BrewTroller/BoardFiles/Phoenix 2.0/Bill-of-Materials-BrewTroller-Phoenix-exported-2017-03-02.xls

BrewTroller Phoenix
# | Designator | Footprint | Package ID | Company P/N | Identifier | Description | ROHS | Quantity | Manufacturer | Manufacturer P/N | Supplier | Supplier P/N | Notes | Price | Total Cost | Datasheet
1 | C1 C2 C3 C4 C6 C7 C12 C13 C14 C15 C16 C17 C18 C20 C21 C22 C23 C25 C26 C27 C28 C30 C31 C32 C33 C34 C35 C36 C38 C40 C46 C47 C48 C49 C50 C51 C52 C53 C54 C55 C56 C57 |  |  | CAP-SMD-3 |  | 0603 0.1 uF 50 V -20 / +80 % Tolerance Y5V SMT Multilayer Ceramic Capacitor |  | 42 | Yageo | CC0603ZRY5V9BB104 | Digikey | 311-1343-1-ND |  | 0.0366 | 1.5372 | http://datasheet.octopart.com/CC0603ZRY5V9BB104-Yageo-datasheet-10882999.pdf
2 | C24 C29 C37 C45 |  |  | CAP-SMD-4 |  | 0603 18 pF 50 V ±5% Tolerance C0G SMT Multilayer Ceramic Capacitor |  | 4 | Murata | GRM1885C1H180JA01D | Digikey | 490-1409-1-ND |  | 0.0222 | 0.0888 | http://datasheet.octopart.com/GRM1885C1H180JA01D-Murata-datasheet-8817987.pdf
3 | C41 C42 C43 C44 |  |  | CAP-SMD-7 |  | Cap Ceramic 0.3pF 50V C0G 0.1pF SMD 0603 125°C Paper T/R |  | 4 | Samsung | CL10C0R3BB8NNNC | Digikey | CL10C0R3BB8NNNC |  | 0.004 | 0.016 | http://datasheet.octopart.com/CL10C0R3BB8NNNC-Samsung-Electro-Mechanics-datasheet-11801255.pdf
4 | C8 |  |  | CAP-SMD-8 |  | 0603 160 pF 50 V ±5% Tolerance C0G SMT Multilayer Ceramic Capacitor |  | 1 | Murata | GRM1885C1H161JA01D | Ali Express | GRM1885C1H161JA01D |  | 0.0254 | 0.0254 | http://datasheet.octopart.com/GRM1885C1H161JA01D-Murata-datasheet-12553306.pdf
5 | C19 |  |  | CAP-SMD-9 |  | 0603 1UF 105K X5R 50V +-10% SMD Ceramic capacitor CL31A106KOHNNNE 4000PCS RoHS 100% rohs novo! SAMSUNG |  | 1 | Samsung | CL31A106KOHNNNE | Aliexpress | CL31A106KOHNNNE |  | 0.01 | 0.01
6 | C39 |  |  | CAP-SMD-ALUM-1 |  | UD Series 68 uF 35 V 105°C Ø6.3 x 7.7mm SMT Chip Aluminum Electrolytic Cap |  | 1 | Nichicon | UUD1V680MCL1GS | Ali Express | UUD1V680MCL1GS |  | 0.1182 | 0.1182 | http://datasheet.octopart.com/UUD1V680MCL1GS-Nichicon-datasheet-12981252.pdf
7 | C5 |  |  | CAP-SMD-ALUM-2 |  | WX Series 100 uF 25 V ±20 % Surface Mount Chip Aluminum Electrolytic Capacitor |  | 1 | Nichicon | UWX1E101MCL1GB |  | 493-2113-1-ND |  | 0.2106 | 0.2106 | http://datasheet.octopart.com/UWX1E101MCL1GB-Nichicon-datasheet-12519344.pdf
8 | C10 C9 |  |  | CAP-SMD-Polymer-2 |  | HS Series 1000 uF 6.3V 20% Surface Mount Polymer Aluminum Electrolytic Capacitor |  | 2 | Nichicon | RHS0J102MCN1GS |  | 493-3774-2-ND |  | 0.9064 | 1.8128 | http://datasheet.octopart.com/RHS0J102MCN1GS-Nichicon-datasheet-12513564.pdf
9 | C11 |  |  | CAP-TANT-SMD-3 |  | Cap Tant Solid 22uF 6.3V B CASE 20% (3.5 X 2.8 X 1.9mm) SMD 3528-21 2.5 Ohm 125C Automotive T/R |  | 1 | Kemet | T491B226M006AT |  | 399-8313-1-ND |  | 0.2102 | 0.2102 | http://datasheet.octopart.com/T491B226M006AT-Kemet-datasheet-41473941.pdf
10 | XTAL1 |  |  | CRYSTAL-SMD-1 |  | Crystal 16MHz ??30ppm (Tol) ??30ppm (Stability) 18pF FUND 40Ohm 4-Pin SMD T/R |  | 1 | TXC | 7B-16.000MAAJ-T | Digikey | 7B-16.000MAAJ-T |  | 0.726 | 0.726 | http://datasheet.octopart.com/7B-16.000MAAJ-T-TXC-datasheet-8857370.pdf
11 | XTAL2 |  |  | CRYSTAL-SMD-2 |  | Crystal 25.0000mhz 18pf Smd |  | 1 | TXC | 7B-25.000MAAJ-T | Digikey | 7B-25.000MAAJ-T |  | 0.726 | 0.726 | http://datasheet.octopart.com/7B-25.000MAAJ-T-TXC-datasheet-10214950.pdf
12 | D1 |  |  | DIODE-SMD-2 |  | DIODE, TVS, 12V, 400W; Diode Type: TVS, Unidirectional; Voltage, Vbr: 14.7V; Power, Peak Pulse: 400W; Case Style: SMA... |  | 1 | Multicomp | SMAJ12A | Ali Express | SMAJ12A |  | 0.2214 | 0.2214 | http://datasheet.octopart.com/SMAJ12A-Multicomp-datasheet-10125818.pdf
13 | D2 |  |  | DIODE-SMD-SCH-1 |  | B250A Series 50 V 2 A Surface Mount Schottky Barrier Rectifier - DO-214AC |  | 1 | Diodes Inc. | B250A-13-F | Digikey | B250A-13-F |  | 0.391 | 0.391 | http://datasheet.octopart.com/B250A-13-F-Diodes-Inc.-datasheet-46751036.pdf
14 | D10 D3 D4 D5 D6 D7 D8 D9 |  |  | DIODE-ZENER-1 |  | BZX384 Series 5.1 V ±5 % 300 mW Surface Mount Voltage Regulator Diode - SOD323 |  | 8 | NXP Semiconductors | BZX384-C5V1,115 |  | 568-8045-2-ND |  | 0.1621 | 1.2968 | http://datasheet.octopart.com/BZX384-C5V1%2C115-NXP-Semiconductors-datasheet-8360268.pdf
15 | L1 L3 L5 L6 L7 L8 |  |  | FERRITE-SMD-2 |  | Ferrite Beads High Current Chip 100Ohm 25% 100MHz 3A 35mOhm DCR 1206 T/R |  | 6 | Laird | HI1206N101R-10 | Digikey | HI1206N101R-10 |  | 0.055 | 0.33 | http://datasheet.octopart.com/HI1206N101R-10-Steward-datasheet-14357201.pdf
16 | L4 |  |  | FERRITE-SMD-3 |  | Ind Chip Bead Multi-Layer 100Ohm 25% 100MHz Ferrite 3A 0603 Punched Paper T/R |  | 1 | TDK | MPZ1608S101ATAH0 |  | 445-1564-1-ND |  | 5.0036 | 5.0036 | http://datasheet.octopart.com/MPZ1608S101ATAH0-TDK-datasheet-8852356.pdf
17 | L2 |  |  | FIX-IND-SMD-1 |  | Inductor Power Shielded Wirewound 3.5uH/5.4uH 30% 100KHz 2.5A 33mOhm DCR T/R |  | 1 | Pulse | P1167.542NLT | Digikey | P1167.542NLT |  | 1.613 | 1.613 | http://datasheet.octopart.com/P1167.542NLT-Pulse-datasheet-5389958.pdf
18 | U$6 |  |  | FUSE-SMD-1 |  | 2018 SMD PTC Resettable Fuses, 15V, 1.5A |  | 1 | Bourns | MF-SMDF150-2 | Digikey | MF-SMDF150-2TR-ND |  | 0.5004 | 0.5004 | http://datasheet.octopart.com/MF-SMDF150-2-Bourns-datasheet-8547340.pdf
19 | X3 |  |  | HEADER-TH-M-1 |  | Wire-To-Board Connector, SL 70545 Series, Through Hole, Header, 4, 2.54 mm, Gold Plated Contacts |  | 1 | Molex | 70545-0038 | Digikey | 70545-0038 |  | 0.908 | 0.908 | http://datasheet.octopart.com/70545-0038-Molex-datasheet-13786230.pdf
20 | X2 |  |  | HEADER-TH-M-2 |  | CGrid SL Srd VHdr SR 120 TPg 15Au 5Ckt |  | 1 | Molex | 70545-0039 | Digikey | 70545-0039 |  | 0.8988 | 0.8988 | http://datasheet.octopart.com/70545-0039-Molex-datasheet-37172048.pdf
21 | JP1 JP3 |  |  | HEADER-TH-M-3 |  | Header; PinStrip; CopperAlloy; GlassFilledPolyester; 36Cnts; 2.5A; Straight; 929Series |  | 2 | 3M | 929400-01-36-RK | DIGIKEY | 929400E-01-36-ND |  | 1.22 | 2.44 | http://datasheet.octopart.com/929400-01-36-RK-3M-datasheet-5333537.pdf
22 | IC10 |  |  | IC-SMD-10 |  | 23K256 Series 2.7 to 3.6 V 256 kbit SPI Bus Lower Power Serial SRAM TSSOP-8 |  | 1 | Microchip | 23K256-I/ST | Digikey | 23K256-I/ST |  | 1.1 | 1.1 | http://datasheet.octopart.com/23K256-I/ST-Microchip-datasheet-10414480.pdf
23 | IC12 |  |  | IC-SMD-11 |  | SP485E Series 10 Mbps 5 V Enhanced Low EMI Half Duplex RS-485 Transceiver-NSOIC8 |  | 1 | Exar | SP485ECN-L | Ali Express | SP485ECN-L |  | 0.324 | 0.324 | http://datasheet.octopart.com/SP485ECN-L-Exar-datasheet-17722984.pdf
24 | IC2 |  |  | IC-SMD-12 |  | USB Full Speed to Serial UART IC, Includes Oscillator and EEPROM - SSOP-28 |  | 1 | FTDI | FT232RL-REEL | Ali Express | FT232RL-REEL |  | 1.5152 | 1.5152 | http://datasheet.octopart.com/FT232RL-REEL-FTDI-datasheet-11992319.pdf
25 | IC6 |  |  | IC-SMD-13 |  | Temperature sensor; serial output; -40÷125°C; SOT23A-5; SMD |  | 1 | Microchip | TC74A0-5.0VCTTR | Digikey | TC74A0-5.0VCTTR |  | 0.87 | 0.87 | http://datasheet.octopart.com/TC74A0-5.0VCTTR-Microchip-datasheet-4412.pdf
26 | IC3 IC4 |  |  | IC-SMD-2 |  | 74HC Series 6 V 3-State 8-Bit Serial-In Serial or Parallel-Out Shift Register |  | 2 | NXP Semiconductors | 74HC595D,118 | Digikey | 568-1483-1-ND |  | 0.1552 | 0.3104 | http://datasheet.octopart.com/74HC595D%2C118-Philips-datasheet-11979826.pdf
27 | IC1 |  |  | IC-SMD-3 |  | Conv DC-DC Single Inv/Step Up/Step Down 3V to 40V 8-Pin SOIC T/R |  | 1 | Texas Instruments | MC34063ADR | Digikey | 296-17765-2-ND |  | 0.4638 | 0.4638 | https://octopart-clicks.com/click/track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
28 | IC9 |  |  | IC-SMD-4 |  | LF Series 3.3 V 500 mA Very Low Drop Voltage Regulator With Inhibit - TO-252 |  | 1 | STMicroelectronics | LF33CDT-TR | Digikey | 497-1532-6-ND |  | 0.5422 | 0.5422 | http://datasheet.octopart.com/LF33CDT-TR-STMicroelectronics-datasheet-10887915.pdf
29 | IC5 |  |  | IC-SMD-5 |  | 25AA02E48 Series 2 Kbit (256 x 8) 5.5 V SMT SPI Bus Serial EEPROM - SOT-23-6 |  | 1 | Microchip | 25AA02E48T-I/OT | Digikey | 25AA02E48T-I/OT |  | 0.38 | 0.38 | http://datasheet.octopart.com/25AA02E48T-I/OT-Microchip-datasheet-11068214.pdf
30 | IC7 |  |  | IC-SMD-6 |  | SST26VF032 Series 32 Mb (4M x 8) 3.6 V Serial Quad I/O Flash Memory - SOIJ-8 |  | 1 | Microchip | SST26VF032B-104I/SM | Digikey | SST26VF032B-104I/SM |  | 1.89 | 1.89 | http://datasheet.octopart.com/SST26VF032B-104I-SM-Microchip-datasheet-38329582.pdf
31 | IC13 |  |  | IC-SMD-7 |  | I2C to 1 Wire Bridge Device 8-Pin SOIC N T/R |  | 1 | Maxim Integrated | DS2482S-100+T&R | Digikey | DS2482S-100+T&R |  | 1.58 | 1.58 | http://datasheet.octopart.com/DS2482S-100%2BT%26R-Dallas-Semiconductor-datasheet-12994239.pdf
32 | IC8 |  |  | IC-SMD-8 |  | Wafer with customer specific RDL - 20MHZ, TQFP, IND TEMP, GREEN, 1.8V, T&R/ TQFP (A) |  | 1 | Atmel | ATMEGA1284P-AUR | Ali Express | ATMEGA1284P-AUR |  | 6.28 | 6.28 | http://datasheet.octopart.com/ATMEGA1284P-AUR-Atmel-datasheet-17360070.pdf
33 | IC11 |  |  | IC-SMD-9 |  | MCU 8-bit PIC18 PIC RISC 128KB Flash 1.8V/2.5V/3.3V 64-Pin TQFP Tray |  | 1 | Microchip | PIC18F67J60-I/PT | Ali Express | PIC18F67J60-I/PT |  | 2.2606 | 2.2606 | http://datasheet.octopart.com/PIC18F67J60-I/PT-Microchip-datasheet-11052749.pdf
34 | LED10 LED11 LED12 LED13 LED14 LED15 LED16 LED17 LED18 LED19 LED2 LED20 LED21 LED22 LED23 LED27 LED28 LED29 LED3 LED30 LED4 LED5 LED6 LED7 LED8 LED9 |  |  | LED-SMD-GREEN-1 |  | Green 1.6 x 0.8 x 0.8 mm 130° Water Clear 6 mcd 2.1 V SMT LED |  | 26 | Lite-On | LTST-C190GKT | Ali Express | LTST-C190GKT |  | 0.0115 | 0.299 | http://datasheet.octopart.com/LTST-C190GKT-Lite-On-datasheet-158530.pdf
35 | LED1 |  |  | LED-SMD-RED-1 |  | LED; SMD; 0603; red; 18-54mcd; 1.6x0.8x0.55mm; 130°; 2÷2.4V; 20mA |  | 1 | Lite-On | LTST-C191KRKT | Ali Express | LTST-C191KRKT |  | 0.0121 | 0.0121 | http://datasheet.octopart.com/LTST-C191KRKT-Lite-On-datasheet-158249.pdf
36 | LED24 LED25 LED26 |  |  | LED-TH-TAPERED-GREEN-1 |  |  |  | 3 |  |  |  |  | On Hand | 0 | 0
37 | OK1 |  |  | OPTO-SMD-1 |  | PC817 Series 1 Channel 80 V 5000 Vrms SMT General Purpose Photocoupler - DIP-4 |  | 1 | Sharp Microelectronics | PC817XNNIP0F | Digikey | PC817XNNIP0F |  | 0.384 | 0.384 | http://datasheet.octopart.com/PC817XNNIP0F-Sharp-Microelectronics-datasheet-26446366.pdf
38 | R15 R16 R17 R18 |  |  | RES-ARRAY-SMD-1 |  | Res Thick Film Array 10K Ohm 5% ?200ppm/C ISOL Molded 8-Pin 1206(4 X 0603) Convex SMD T/R |  | 4 | Vishay | CRA06S08310K0JTA | Digikey | CRA6S810KTR-ND |  | 0.0462 | 0.1848 | http://datasheet.octopart.com/CRA06S08310K0JTA-Vishay-datasheet-5334942.pdf
39 | R10 R11 R7 R8 R9 |  |  | RES-ARRAY-SMD-2 |  | Res Thick Film Array 330 Ohm 5% ?200ppm/C ISOL Molded 8-Pin 1206(4 X 0603) Convex SMD Automotive T/R |  | 5 | Panasonic | EXB-38V331JV | Digikey | Y9331TR-ND |  | 0.0312 | 0.156 | http://datasheet.octopart.com/EXB-38V331JV-Panasonic-datasheet-13266625.pdf
40 | R48 R49 |  |  | RES-ARRAY-SMD-3 |  | Res Thick Film Array 3.3K Ohm 5% ?200ppm/C ISOL Molded 8-Pin 1206(4 X 0603) Convex SMD Automotive T/R |  | 2 | Panasonic | EXB-38V332JV | Digikey | EXB-38V332JV |  | 0.0341 | 0.0682 | http://datasheet.octopart.com/EXB-38V332JV-Panasonic-datasheet-13266625.pdf
41 | R14 |  |  | RES-SMD-1 |  | Res Thick Film 2512 0.1 Ohm 5% 1W ±200ppm/°C Molded SMD Embossed Plastic T/R |  | 1 | TE Connectivity / AMP | 1622825-9 | Digikey | A103652DKR-ND |  | 0.243 | 0.243 | http://datasheet.octopart.com/1622825-9-TE-Connectivity---AMP-datasheet-11120217.pdf
42 | R32 |  |  | RES-SMD-12 |  | Res Thick Film 0603 2.26K Ohm 1% 0.1W(1/10W) Â±100ppm/Â°C Molded SMD Automotive Punched T/R |  | 1 | Panasonic | ERJ-3EKF2261V | Digkey | P2.26KHTR-ND |  | 0.0086 | 0.0086 | http://datasheet.octopart.com/ERJ-3EKF2261V-Panasonic-datasheet-13266541.pdf
43 | R38 R44 |  |  | RES-SMD-16 |  | Resistor Thick Film 0603 2k Ohm 5% 1/10 Watt ±200ppm °C Surface Mount Punched Carrier Tape and Reel |  | 2 | Panasonic | ERJ-3GEYJ202V | Digikey | P2.0KGTR-ND |  | 0.0074 | 0.0148 | http://datasheet.octopart.com/ERJ-3GEYJ202V-Panasonic-datasheet-13266872.pdf
44 | R3 |  |  | RES-SMD-18 |  | Res Thick Film 0805 3.3K Ohm 5% 0.125W(1/8W) ?100ppm/C Molded SMD Automotive Paper T/R |  | 1 | Yageo | RC0805JR-073K3L | Digikey | 311-3.3KARCT-ND |  | 0.0306 | 0.0306 | http://datasheet.octopart.com/RC0805JR-073K3L-Yageo-datasheet-8330313.pdf
45 | R5 R6 R19 R25 R51 R53 |  |  | RES-SMD-20 |  | Res Thick Film 0603 330 Ohm 5% 0.1W(1/10W) Â±200ppm/Â°C Molded SMD Automotive Punched T/R |  | 6 | Panasonic | ERJ-3GEYJ331V | Digikey | P330GTR-ND |  | 0.0081 | 0.0486 | http://datasheet.octopart.com/ERJ-3GEYJ331V-Panasonic-datasheet-13266872.pdf
46 | R2 R35 R55 R56 R57 R58 R59 R60 R61 R62 R63 R64 R65 R66 R67 R68 R69 R70 R71 R72 R73 R74 |  |  | RES-SMD-22 |  | Res Thick Film 0603 4.7K Ohm 5% 0.1W(1/10W) Â±200ppm/Â°C Molded SMD Automotive Punched T/R |  | 2 | Panasonic | ERJ-3GEYJ472V | Digikey | P4.7KGTR-ND |  | 0.0081 | 0.0162 | http://datasheet.octopart.com/ERJ-3GEYJ472V-Panasonic-datasheet-13266872.pdf
47 | R29 R31 R43 R45 R52 R54 |  |  | RES-SMD-25 |  | Res Thick Film 0603 180 Ohm 5% 0.1W(1/10W) Â±200ppm/Â°C Molded SMD Automotive Punched T/R |  | 6 | Panasonic | ERJ-3GEYJ181V | Digkey | P180GTR-ND |  | 0.0104 | 0.0624 | http://datasheet.octopart.com/ERJ-3GEYJ181V-Panasonic-datasheet-13266872.pdf
48 | R33 R34 R36 R37 |  |  | RES-SMD-28 |  | Res Thick Film 0603 49.9 Ohm 1% 0.1W(1/10W) ±100ppm/°C Molded SMD Punched Carrier T/R |  | 4 | Panasonic | ERJ-3EKF49R9V | Digikey | P49.9HTR-ND |  | 0.0132 | 0.0528 | http://datasheet.octopart.com/ERJ-3EKF49R9V-Panasonic-datasheet-13266541.pdf
49 | R50 |  |  | RES-SMD-3 |  | Res Thick Film 0603 100 Ohm 5% 0.1W(1/10W) Â±200ppm/Â°C Molded SMD Automotive Punched T/R |  | 1 | Panasonic | ERJ-3GEYJ101V | Digikey | P100GTR-ND |  | 0.0071 | 0.0071 | http://datasheet.octopart.com/ERJ-3GEYJ101V-Panasonic-datasheet-13266872.pdf
50 | R13 |  |  | RES-SMD-32 |  | Res Thick Film 0603 30K Ohm 5% 0.1W(1/10W) ??200ppm/C Molded SMD Automotive Punched T/R |  | 1 | Panasonic | ERJ-3GEYJ303V |  | P30KGTR-ND |  | 0.0071 | 0.0071 | http://datasheet.octopart.com/ERJ-3GEYJ303V-Panasonic---ECG-datasheet-13266872.pdf
51 | R20 |  |  | RES-SMD-4 |  | Res Thick Film 0603 100K Ohm 5% 0.1W(1/10W) Â±200ppm/Â°C Molded SMD Automotive Punched T/R |  | 2 | Panasonic | ERJ-3GEYJ104V | Digkey | P100KGTR-ND |  | 0.0101 | 0.0202 | http://datasheet.octopart.com/ERJ-3GEYJ104V-Panasonic-datasheet-13266872.pdf
52 | R4 R21 R22 R23 R24 R27 R28 R30 R39 R40 R41 R42 |  |  | RES-SMD-5 |  | RC Series 0603 0.1 W 10 kOhms 5% ±100 ppm/°C SMT Thick Film Chip Resistor |  | 13 | Yageo | RC0603JR0710KL | Digikey | 311-10KGRTR-ND |  | 0.0354 | 0.4602 | http://datasheet.octopart.com/RC0603JR-0710KL-Yageo-datasheet-8328172.pdf
53 | R12 |  |  | RES-SMD-5 |  | RC Series 0603 0.1 W 10 kOhms 5% ±100 ppm/°C SMT Thick Film Chip Resistor |  | 1 | Yageo | RC0603JR0710KL | Digikey | 311-10KGRTR-ND |  | 0.0354 | 0.0354 | http://datasheet.octopart.com/RC0603JR-0710KL-Yageo-datasheet-8328172.pdf
54 | R1 R26 |  |  | RES-SMD-9 |  | RC Series 0603 0.1 W 1 kOhms 5% ±100 ppm/°C SMT Thick Film Chip Resistor |  | 2 | Yageo | RC0603JR-071KL | Digikey | 311-1.0KGRTR-ND |  | 0.0335 | 0.067 | http://datasheet.octopart.com/RC0603JR-071KL-Yageo-datasheet-8328172.pdf
55 | $$U$1 |  |  | SCREW-TERM-TH-1 |  | Conn; Term Blk; PCB; 2; 3.5 mm; Front; 26-16 AWG; 10 A; 300 V; 1.2 mm PA |  | 1 | Phoenix Contact | 1984617 |  | 277-1721-ND |  | 0.3545 | 0.3545 | http://datasheet.octopart.com/1984617-Phoenix-Contact-datasheet-67368.pdf
56 | JP6 |  |  | SCREW-TERM-TH-1 |  | Conn; Term Blk; PCB; 2; 3.5 mm; Front; 26-16 AWG; 10 A; 300 V; 1.2 mm PA |  | 17 | Phoenix Contact | 1984617 |  | 277-1721-ND |  | 0.3545 | 6.0265 | http://datasheet.octopart.com/1984617-Phoenix-Contact-datasheet-67368.pdf
57 | JP5 |  |  | SCREW-TERM-TH-1 |  | Conn; Term Blk; PCB; 2; 3.5 mm; Front; 26-16 AWG; 10 A; 300 V; 1.2 mm PA |  | 3 | Phoenix Contact | 1984617 |  | 277-1721-ND |  | 0.3545 | 1.0635 | http://datasheet.octopart.com/1984617-Phoenix-Contact-datasheet-67368.pdf
58 | JP4 |  |  | SCREW-TERM-TH-2 |  | Conn; Term Blk; PCB; 3; 3.5 mm; Front; 26-16 AWG; 10 A; 300 V; 1.2 mm PA |  | 3 | Phoenix Contact | 1984620 |  | 277-1722-ND |  | 0.563 | 1.689 | http://datasheet.octopart.com/1984620-Phoenix-Contact-datasheet-9931644.pdf
59 | INPUTS |  |  | SCREW-TERM-TH-2 |  | Conn; Term Blk; PCB; 3; 3.5 mm; Front; 26-16 AWG; 10 A; 300 V; 1.2 mm PA |  | 3 | Phoenix Contact | 1984620 |  | 277-1722-ND |  | 0.563 | 1.689 | http://datasheet.octopart.com/1984620-Phoenix-Contact-datasheet-9931644.pdf
60 | S1 S2 |  |  | SWITCH-SMD-TAC-1 |  | Switch Tactile Spst-No 0.05a 12v |  | 2 | C&K Components | RS-187R05A2-DS MT RT | Ali Express | CKN10361CT-ND | http://www.aliexpress.com/item/100PCS-SMD-SWITCH-5-2mm-x-5-2mm-x-1-5-Tact-Switch-NEW-GOOD-QUALITY/32392066767.html | 0.03 | 0.06
61 | JP2 |  |  | TERMBLOCK-TH-5.0-1 |  | Conn Terminal Blocks 2 POS 5mm Solder ST Thru-Hole 16A |  | 1 | Phoenix Contact | 1935161 | Digikey | 277-1667-ND |  | 0.115 | 0.115 | http://datasheet.octopart.com/1935161-Phoenix-Contact-datasheet-98533.pdf
62 | X4 |  |  | TH-ETH-1 |  | From Aliexpress, needs replaced |  | 1 |  | SK01-001NL | Aliexpress | SK01-001NL | http://www.aliexpress.com/snapshot/6849511075.html?orderId=68821615815333 | 1.99 | 1.99
63 | Q1 Q10 Q11 Q12 Q13 Q14 Q15 Q16 Q17 Q18 Q19 Q2 Q20 Q3 Q4 Q5 Q6 Q7 Q8 Q9 |  |  | TRANS-SMD-1 |  | IMD10A Series 50 V 500 mA Surface Mount Dual NPN/PNP Digital Transistor - SC-74 |  | 20 | Rohm | IMD10AT108 | Digikey | IMD10AT108CT-ND |  | 0.126 | 2.52 | http://datasheet.octopart.com/IMD10AT108-Rohm-datasheet-568722.pdf
64 | Q21 |  |  | TRANS-SMD-3 |  | MMBT3904 Series NPN 150 mW 40 V SMT General Purpose Amplifier - SOT-523-3 |  | 1 | MCC | MMBT3904-TP | Digikey | MMBT3904-TP |  | 0.116 | 0.116 | http://datasheet.octopart.com/MMBT3904-TP-Micro-Commercial-datasheet-9712332.pdf
65 | X1 |  |  | USB-TH-1 |  | Conn Usb Type b Vertical White |  | 1 | On Shore Technology | USB-B1KSW6 |  | ED2980-ND |  | 0.8234 | 0.8234
