BrewTroller/BoardFiles/I2CLCD/Bill-of-Materials-I2C-LCD-exported-2016-04-29.xls

I2C LCD
# | Designator | Footprint | Package ID | Company P/N | Identifier | Description | ROHS | Quantity | Manufacturer | Manufacturer P/N | Supplier | Supplier P/N | Notes | Price | Total Cost | Datasheet
1 | C1 C2 C3 C4 C5 C6 C8 C9 C10 C11 |  |  | CAP-SMD-3 |  | 0603 0.1 uF 50 V -20 / +80 % Tolerance Y5V SMT Multilayer Ceramic Capacitor |  | 10 | Yageo | CC0603ZRY5V9BB104 | Digikey | 311-1343-1-ND |  | 0.0366 | 0.366 | http://datasheet.octopart.com/CC0603ZRY5V9BB104-Yageo-datasheet-10882999.pdf
2 | C7 |  |  | CAP-TANT-SMD-1 |  | Cap Tant Solid 10uF 10V C CASE 10% (6 X 3.2 X 2.5mm) SMD 6032-28 1.8 Ohm 125°C T/R |  | 1 | Sprague | 293D106X9010C2TE3 | Digikey | 718-1047-1-ND |  | 0.766 | 0.766 | http://datasheet.octopart.com/293D106X9010C2TE3-Vishay-datasheet-7602252.pdf
3 | Y1 |  |  | CRYSTAL-SMD-3 |  | Resonator, Ceramic, 16mhz, Smd-3 |  | 1 | AVX Interconnect / Elco | PRQC16.00SR1010V00L |  | 1253-1339-1-ND |  | 0.472 | 0.472 | http://datasheet.octopart.com/PRQC16.00SR1010V00L-AVX-datasheet-37139415.pdf
4 | ENCODER |  |  | ENCODER-SOCKET-1 |  | Conn; Rect; Header; 6Cnts; ThruMount; Quickie; 2.54mmPin-Spng; Vert; DblRow |  | 1 | FCI | 75869-131LF |  | 609-2845-ND |  | 0.4892 | 0.4892 | http://datasheet.octopart.com/75869-131LF-Areva-datasheet-13726216.pdf
5 | LCD |  |  | HEADER-TH-F-1 |  | 960116-6202-Ar=16/Skt/Bmt/0.1/1r/Str/Pth/7.1ht/3.0/Aufl/Rc |  | 1 | 3M | 960116-6202-AR |  | 3M9520-ND |  | 1.958 | 1.958 | http://datasheet.octopart.com/960116-6202-AR-3M-datasheet-10364838.pdf
6 | JP3 |  |  | HEADER-TH-M-3 |  | Header; PinStrip; CopperAlloy; GlassFilledPolyester; 36Cnts; 2.5A; Straight; 929Series |  | 1 | 3M | 929400-01-36-RK | DIGIKEY | 929400E-01-36-ND |  | 1.22 | 1.22 | http://datasheet.octopart.com/929400-01-36-RK-3M-datasheet-5333537.pdf
7 | IC1 |  |  | IC-SMD-14 |  | ATmega Series 20 MHz 16 KB Flash 1 KB SRAM 8-Bit Microcontroller - TQFP-32 |  | 1 | Atmel | ATMEGA168A-AU |  | ATMEGA168A-AU-ND |  | 1.8799 | 1.8799 | http://datasheet.octopart.com/ATMEGA168A-AU-Atmel-datasheet-14421303.pdf
8 | IC2 |  |  | IC-SMD-7 |  | I2C to 1 Wire Bridge Device 8-Pin SOIC N T/R |  | 1 | Maxim Integrated | DS2482S-100+T&R | Digikey | DS2482S-100+T&R |  | 1.58 | 1.58 | http://datasheet.octopart.com/DS2482S-100%2BT%26R-Dallas-Semiconductor-datasheet-12994239.pdf
9 | LED1 LED2 LED3 LED4 LED5 |  |  | LED-SMD-GREEN-1 |  | Green 1.6 x 0.8 x 0.8 mm 130° Water Clear 6 mcd 2.1 V SMT LED |  | 5 | Lite-On | LTST-C190GKT | Ali Express | LTST-C190GKT |  | 0.0115 | 0.0575 | http://datasheet.octopart.com/LTST-C190GKT-Lite-On-datasheet-158530.pdf
10 | R2 |  |  | RES-ARRAY-SMD-1 |  | Res Thick Film Array 10K Ohm 5% ?200ppm/C ISOL Molded 8-Pin 1206(4 X 0603) Convex SMD T/R |  | 1 | Vishay | CRA06S08310K0JTA | Digikey | CRA6S810KTR-ND |  | 0.0462 | 0.0462 | http://datasheet.octopart.com/CRA06S08310K0JTA-Vishay-datasheet-5334942.pdf
11 | R8 |  |  | RES-SMD-20 |  | Res Thick Film 0603 330 Ohm 5% 0.1W(1/10W) Â±200ppm/Â°C Molded SMD Automotive Punched T/R |  | 1 | Panasonic | ERJ-3GEYJ331V | Digikey | P330GTR-ND |  | 0.0081 | 0.0081 | http://datasheet.octopart.com/ERJ-3GEYJ331V-Panasonic-datasheet-13266872.pdf
12 | R13 |  |  | RES-SMD-3 |  | Res Thick Film 0603 100 Ohm 5% 0.1W(1/10W) Â±200ppm/Â°C Molded SMD Automotive Punched T/R |  | 1 | Panasonic | ERJ-3GEYJ101V | Digikey | P100GTR-ND |  | 0.0071 | 0.0071 | http://datasheet.octopart.com/ERJ-3GEYJ101V-Panasonic-datasheet-13266872.pdf
13 | R4 R5 R9 |  |  | RES-SMD-30 |  | Res Smd 360 Ohm 1% 1/10w 0603 |  | 3 | Yageo | RT0603FRE07360RL | Ali Express | RT0603FRE07360RL-ND | http://www.aliexpress.com/item/360ohm-360-0603-1-1-10W-Chip-Fixed-Resistor-SMD-Resistor-5000pcs/32342453317.html | 0.01 | 0.03 | http://datasheet.octopart.com/RT-Series-Yageo-datasheet-family-29.pdf
14 | R3 |  |  | RES-SMD-5 |  | RC Series 0603 0.1 W 10 kOhms 5% ±100 ppm/°C SMT Thick Film Chip Resistor |  | 1 | Yageo | RC0603JR0710KL | Digikey | 311-10KGRTR-ND |  | 0.0354 | 0.0354 | http://datasheet.octopart.com/RC0603JR-0710KL-Yageo-datasheet-8328172.pdf
15 | R16 |  |  | RES-SMD-6 |  | Res Thick Film 0603 120 Ohm 1% 0.1W(1/10W) Â±100ppm/Â°C Molded SMD Automotive Punched T/R |  | 1 | Panasonic | ERJ-3EKF1200V | Digikey | P120HTR-ND |  | 0.0102 | 0.0102 | http://datasheet.octopart.com/ERJ3EKF1200V-Panasonic-datasheet-13266541.pdf
16 | R1 R6 R7 R10 R11 R12 R14 R15 |  |  | RES-SMD-8 |  | Res Thick Film 0603 1K Ohm 5% 0.1W(1/10W) Â±200ppm/Â°C Molded SMD Automotive Punched T/R |  | 8 | Panasonic | ERJ-3GEYJ102V | Digikey | P1.0KGTR-ND |  | 0.0106 | 0.0848 | http://datasheet.octopart.com/ERJ-3GEYJ102V-Panasonic-datasheet-13266872.pdf
17 | X1 X2 |  |  | SCREW-TERM-TH-1 |  | Conn; Term Blk; PCB; 2; 3.5 mm; Front; 26-16 AWG; 10 A; 300 V; 1.2 mm PA |  | 2 | Phoenix Contact | 1984617 |  | 277-1721-ND |  | 0.3545 | 0.709 | http://datasheet.octopart.com/1984617-Phoenix-Contact-datasheet-67368.pdf
18 | JP2 |  |  | SCREW-TERM-TH-2 |  | Conn; Term Blk; PCB; 3; 3.5 mm; Front; 26-16 AWG; 10 A; 300 V; 1.2 mm PA |  | 1 | Phoenix Contact | 1984620 |  | 277-1722-ND |  | 0.563 | 0.563 | http://datasheet.octopart.com/1984620-Phoenix-Contact-datasheet-9931644.pdf
19 | S1 |  |  | SWITCH-SMD-TAC-1 |  | Switch Tactile Spst-No 0.05a 12v |  | 1 | C&K Components | RS-187R05A2-DS MT RT | Ali Express | CKN10361CT-ND | http://www.aliexpress.com/item/100PCS-SMD-SWITCH-5-2mm-x-5-2mm-x-1-5-Tact-Switch-NEW-GOOD-QUALITY/32392066767.html | 0.03 | 0.03
20 | Q2 |  |  | TRANS-SMD-1 |  | IMD10A Series 50 V 500 mA Surface Mount Dual NPN/PNP Digital Transistor - SC-74 |  | 1 | Rohm | IMD10AT108 | Digikey | IMD10AT108CT-ND |  | 0.126 | 0.126 | http://datasheet.octopart.com/IMD10AT108-Rohm-datasheet-568722.pdf
21 | Q1 |  |  | TRANS-SMD-2 |  | BC807 Series 45 V 500 mA SMT PNP General-Purpose Transistor - SOT-23-3 |  | 1 | NXP Semiconductors | BC807-25,215 | Digikey | 568-4864-1-ND |  | 0.0816 | 0.0816 | http://datasheet.octopart.com/BC807-25%2C215-Philips-datasheet-8521012.pdf
22 | U$1 |  |  | VOLTREG-SMD-1 |  | MIC5205 Series 5 V Fixed Output 150 mA SMT Low-Noise LDO Regulator - SOT-23-5 |  | 1 | Micrel | MIC5205-5.0YM5 TR |  | 576-1261-1-ND |  | 0.4925 | 0.4925 | http://datasheet.octopart.com/MIC5205-5.0YM5-TR-Micrel-datasheet-3438.pdf
