BrewTroller/BoardFiles/I2CLCD/I2CLCD.brd

## EAGLE design I2CLCD/I2CLCD.brd (2020-02-23)

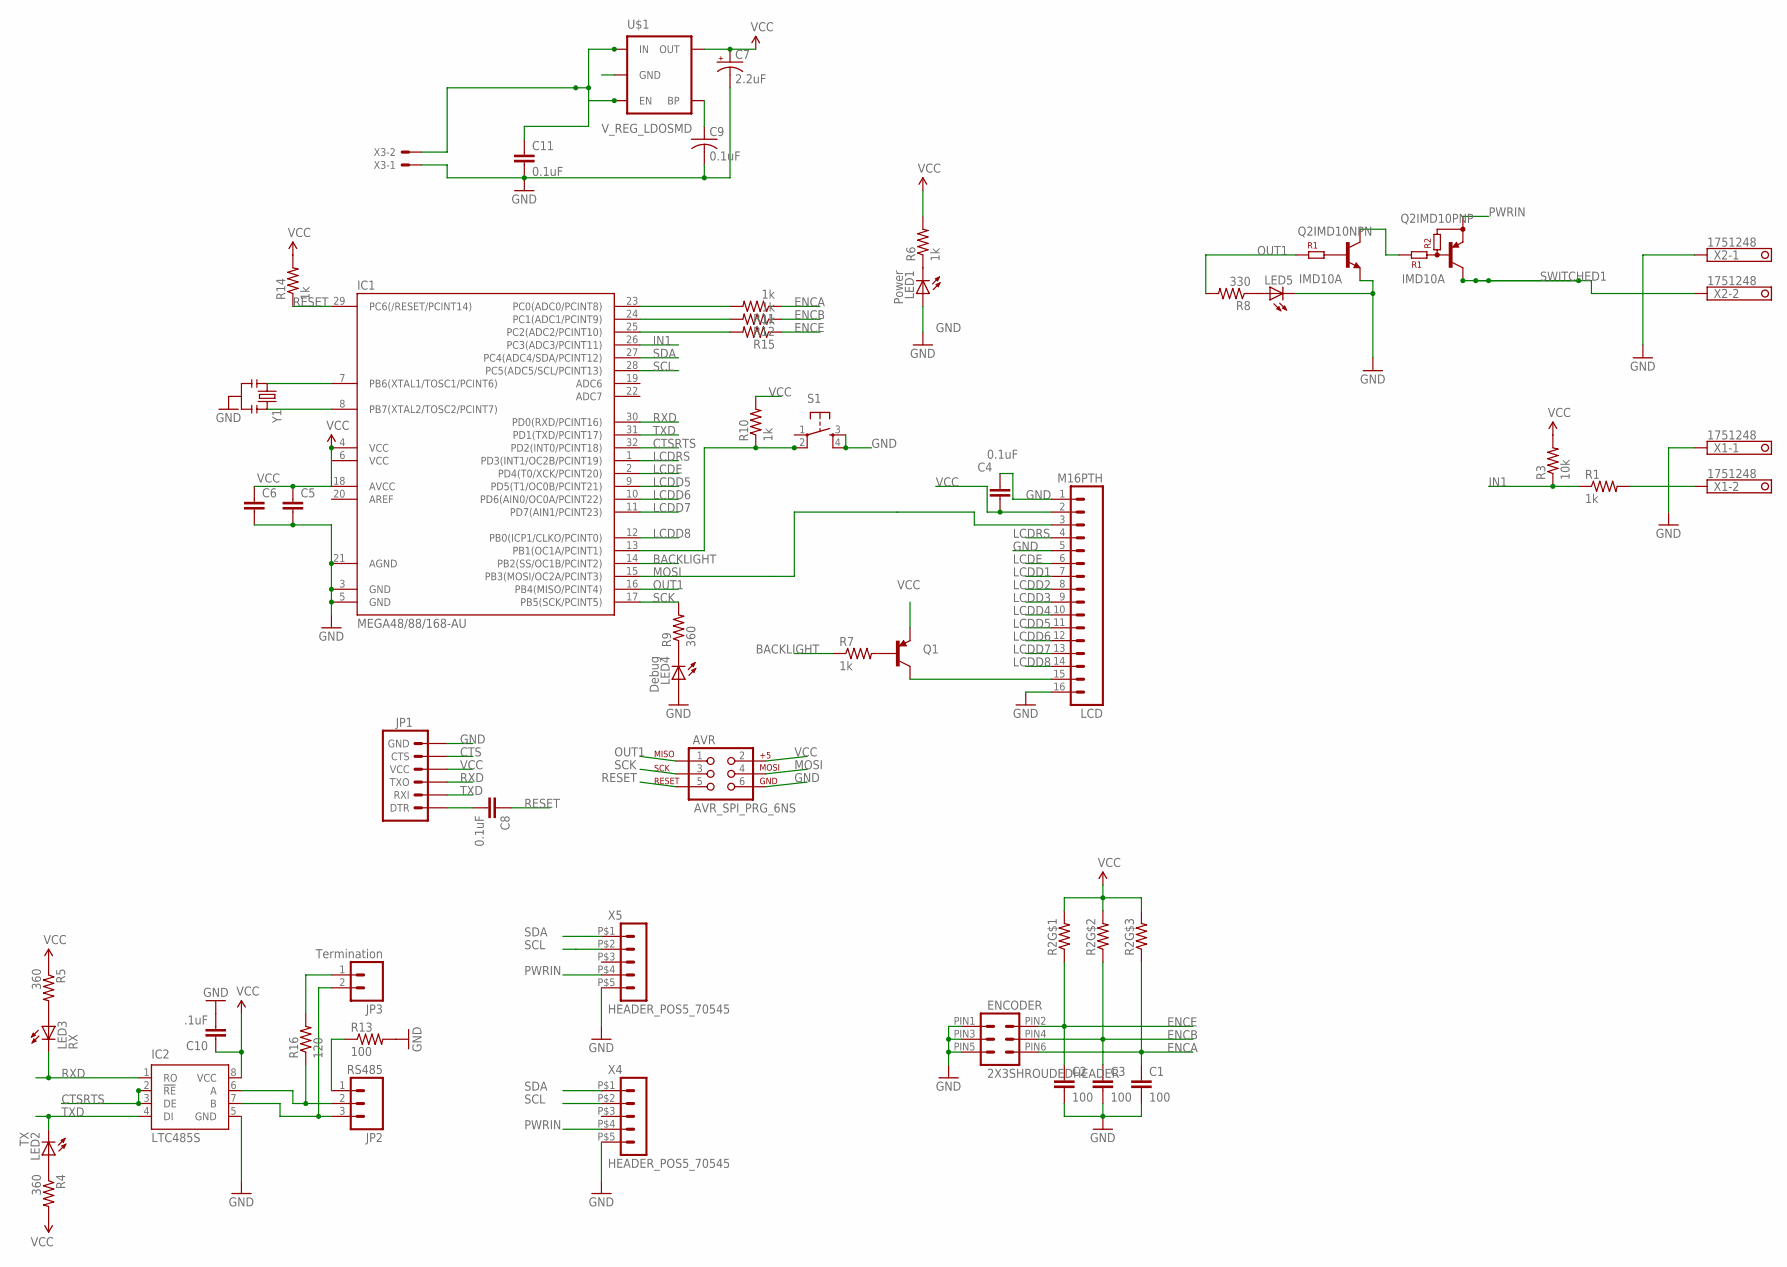
[picture p1: schematic I2CLCD.sch]

Parts:
AVR: AVR_SPI_PRG_6NS; 2X3-NS
C1, C2, C3: 100; 0603-CAP
C4, C8, C11: 0.1uF; 0603-CAP
C5, C6: CAP0603-CAP; 0603-CAP
C7: 2.2uF; EIA3216
C9: 0.1uF; C0603
C10: .1uF; 0603-CAP
ENCODER: 2X3SHROUDEDHEADER
IC1: MEGA48/88/168-AU; TQFP32-08
IC2: LTC485S; SOIC8
JP1: ARDUINO_SERIAL_PROGRAMPTH; 1X06
JP2: RS485; SCREWTERMINAL-3.5MM-3_LOCK.007S
JP3: Termination; 1X02_LOCK
LCD: M16PTH; 1X16
LED1: Power; LED-0603
LED2: TX; LED-0603
LED3: RX; LED-0603
LED4: Debug; LED-0603
LED5: LED0603; LED-0603
Q1: PNP; SOT23-3
Q2: IMD10A; SC-74
R1, R7: 1k; 0603-RES
R2: RESISTOR_4PACK_US; RESPACK_4X0603
R3: 10k; 0603-RES
R4, R5, R9: 360; R0603
R6, R10, R11, R12, R14, R15: 1k; R0603
R8: 330; 0603-RES
R13: 100; 0805
R16: 120; 0603-RES
S1: TAC_SWITCHSMD; TACTILE_SWITCH_SMD
U$1: V_REG_LDOSMD; SOT23-5
X1, X2: 1751248
X3: 22-23-2021
X4, X5: HEADER_POS5_70545; 70545-POS5
Y1: 16Mhz; RESONATOR-SMD

Connections:
A: IC2.6 (A), JP2.2, R16.1
B: IC2.7 (B), JP2.3, JP3.2
BACKLIGHT: IC1.14 (PB2(SS/OC1B/PCINT2)), R7.1
CTS: JP1.5 (CTS)
CTSRTS: IC1.32 (PD2(INT0/PCINT18)), IC2.2 (!RE), IC2.3 (DE)
ENCA: C1.1, ENCODER.PIN6 (6), R2.3 (1), R11.1
ENCAF: IC1.23 (PC0(ADC0/PCINT8)), R11.2
ENCB: C3.1, ENCODER.PIN4 (4), R2.2 (1), R12.1
ENCBF: IC1.24 (PC1(ADC1/PCINT9)), R12.2
ENCE: C2.1, ENCODER.PIN2 (2), R2.1, R15.1
ENCEF: IC1.25 (PC2(ADC2/PCINT10)), R15.2
GND: AVR.6, C1.2, C2.2, C3.2, C4.2, C5.2, C6.2, C7.C (-), C9.2, C10.2, C11.2, ENCODER.PIN1 (1), ENCODER.PIN3 (3), ENCODER.PIN5 (5), IC1.3 (GND), IC1.5 (GND), IC1.21 (AGND), IC2.5 (GND), JP1.6 (GND), LCD.1, LCD.5, LCD.16, LED1.A, LED4.A, LED5.C, Q2.3 (E), R13.2, S1.3, S1.4, U$1.2 (GND), X1.1, X2.1, X3.1, X4.P$5 (5), X5.P$5 (5), Y1.2
IN1: IC1.26 (PC3(ADC3/PCINT11)), R1.1, R3.1
LCDD1: LCD.7
LCDD2: LCD.8
LCDD3: LCD.9
LCDD4: LCD.10
LCDD5: IC1.9 (PD5(T1/OC0B/PCINT21)), LCD.11
LCDD6: IC1.10 (PD6(AIN0/OC0A/PCINT22)), LCD.12
LCDD7: IC1.11 (PD7(AIN1/PCINT23)), LCD.13
LCDD8: IC1.12 (PB0(ICP1/CLKO/PCINT0)), LCD.14
LCDE: IC1.2 (PD4(T0/XCK/PCINT20)), LCD.6
LCDRS: IC1.1 (PD3(INT1/OC2B/PCINT19)), LCD.4
MOSI: AVR.4, IC1.15 (PB3(MOSI/OC2A/PCINT3)), LCD.3
unnamed: LCD.15, Q1.3 (C)
unnamed: IC1.8 (PB7(XTAL2/TOSC2/PCINT7)), Y1.3
unnamed: IC1.7 (PB6(XTAL1/TOSC1/PCINT6)), Y1.1
unnamed: C8.2, JP1.1 (DTR)
unnamed: R1.2, X1.2
unnamed: IC1.13 (PB1(OC1A/PCINT1)), R10.1, S1.2
unnamed: LED4.C, R9.1
unnamed: JP3.1, R16.2
unnamed: LED2.A, R4.1
unnamed: LED1.C, R6.1
unnamed: C9.1, U$1.4 (BP)
unnamed: Q1.1 (B), R7.2
unnamed: LED5.A, R8.1
unnamed: Q2.4 (C), Q2.5 (B)
unnamed: JP2.1, R13.1
unnamed: LED3.A, R5.2
OUT1: AVR.1, IC1.16 (PB4(MISO/PCINT4)), Q2.2 (B), R8.2
PWRIN: C11.1, Q2.6 (E), U$1.1 (IN), U$1.3 (EN), X3.2, X4.P$4 (4), X5.P$4 (4)
RESET: AVR.5, C8.1, IC1.29 (PC6(/RESET/PCINT14)), R14.1
RXD: IC1.30 (PD0(RXD/PCINT16)), IC2.1 (RO), JP1.3 (TXO), LED3.C
SCK: AVR.3, IC1.17 (PB5(SCK/PCINT5)), R9.2
SCL: IC1.28 (PC5(ADC5/SCL/PCINT13)), X4.P$2 (2), X5.P$2 (2)
SDA: IC1.27 (PC4(ADC4/SDA/PCINT12)), X4.P$1 (1), X5.P$1 (1)
SWITCHED1: Q2.1 (C), X2.2
TXD: IC1.31 (PD1(TXD/PCINT17)), IC2.4 (DI), JP1.2 (RXI), LED2.C
VCC: AVR.2, C4.1, C5.1, C6.1, C7.A (+), C10.1, IC1.4 (VCC), IC1.6 (VCC), IC1.18 (AVCC), IC2.8 (VCC), JP1.4 (VCC), LCD.2, Q1.2 (E), R2.6 (2), R2.7 (2), R2.8 (2), R3.2, R4.2, R5.1, R6.2, R10.2, R14.2, U$1.5 (OUT)

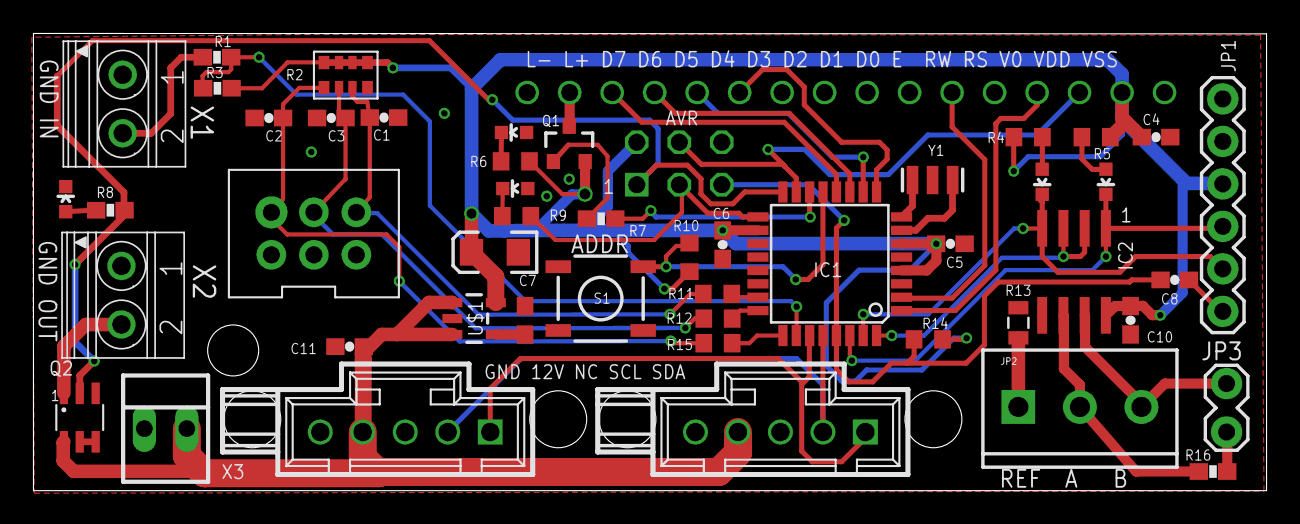
[picture p2: board I2CLCD.brd from above]

Board: 2 copper layers, 73.7 x 27.3 mm, 51 parts (1 on the bottom side), 45 nets.

Other parts of the board:
U$2: STAND-OFF-TIGHT
