BrewTroller/BoardFiles/Phoenix 2.0/BrewTrollerPhoenix.brd

## EAGLE design Phoenix 2.0/BrewTrollerPhoenix.brd (2020-02-23)

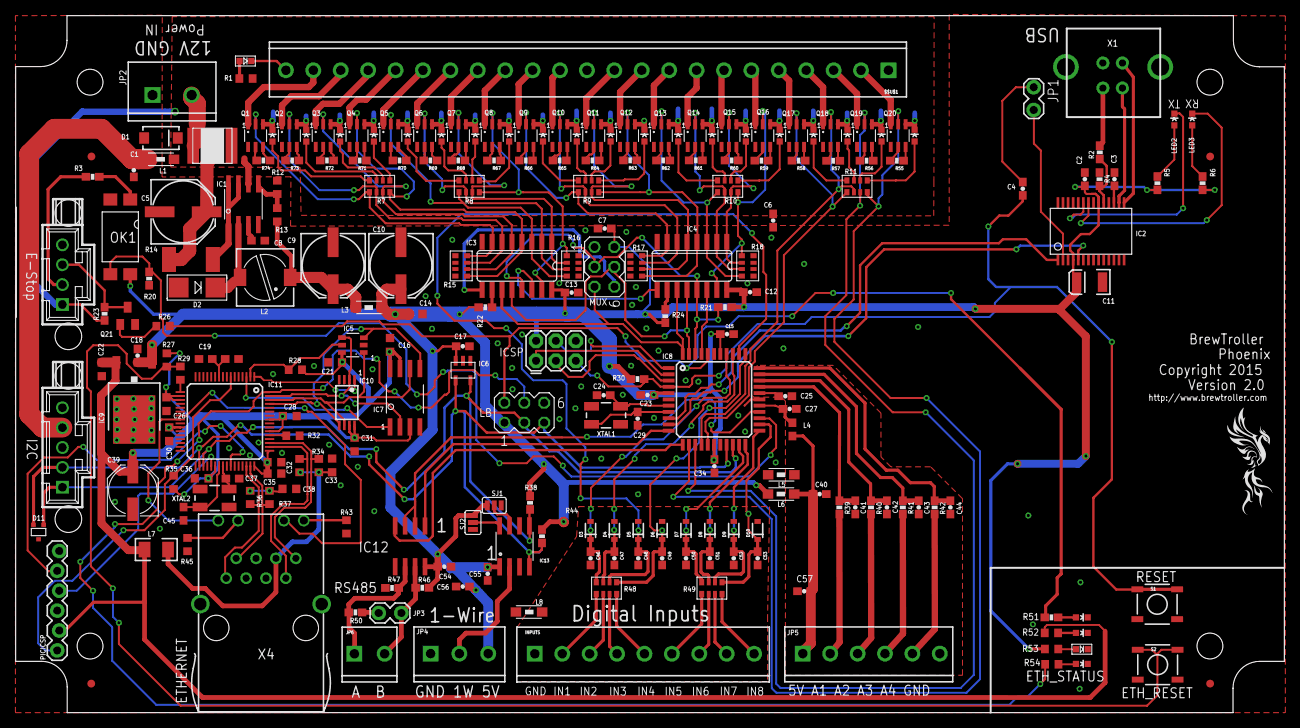
[picture p3: board BrewTrollerPhoenix.brd from above]

Board: 2 copper layers, 162.0 x 89.0 mm, 241 parts (0 on the bottom side), 215 nets.

Parts:
$$$$$$U$1, $$$$$$U$2: STAND-OFF
$$$$U$1, $$$$U$3: STAND-OFF
$$$$U$2: FIDUCIAL; FIDUCIAL_1MM
$$U$1: M23; SCREWTERMINAL3.5MM-23
$$U$2: FIDUCIAL; FIDUCIAL_1MM
$$U$3: GEAR-STOP-SMALL
BOARDZERO: FIDUCIAL; FIDUCIAL_1MM
C1, C2, C3, C4, C6, C7, C12, C13, C15, C17, C18, C23, C25, C27, C34, C40, C54, C55, C56, C57: .1uF; 0603-CAP
C5: 100uf; PANASONIC_E
C8: 160pF; C0603
C9, C10: 1000uf; PANASONIC_E
C11: 4.7uF; EIA3528
C14, C16, C21, C22, C26, C28, C30, C31, C32, C33, C35, C36, C38: .1uF; C0603K
C19: 1uF; C0603
C20: .1uF; C0603
C24, C29: 18pf; 0603-CAP
C37, C45: 18pF; C0603
C39: 68uF; PANASONIC_D
C41, C42, C43, C44: .33uF; 0603-CAP
C46, C47, C48, C49, C50, C51, C52, C53: 0603-CAP
D1: TVS; SMA-DIODE
D2: 2A SHOTKEY; SMADIODE
D3, D4, D5, D6, D7, D8, D9, D10: DIODE-ZENER-BZT52; SOD-323
D11: TVS; SOT23-3
IC1: SOIC8
IC2: FT232RLSSOP; SSOP28DB
IC3, IC4: 74LS595D; SO16
IC5: 25AA02E48; SOT23-6
IC6: TC74; SOT-23A-5
IC7: SST25VF032B; SO8W
IC8: ATMEGA1284; TQFP44
IC9: 3.3V; TO252
IC10: 23K256; TSSOP8
IC11: PIC18F67J60; TQFP64-10X10
IC12: LTC485S; SOIC8
IC13: DS2482; SO8
ICSP: AVR_SPI_PRG_6PTH; 2X3
INPUTS: M09; SCREWTERMINAL3.5MM-9
JP1: AutoReset; 1X02_LOCK
JP2: PWRIN; SCREWTERMINAL-5MM-2
JP3: Termination; 1X02_LOCK
JP4: OneWire; SCREWTERMINAL-3.5MM-3_LOCK.007S
JP5: M063.5MM6; SCREWTERMINAL3.5MM6
JP6: SCREWTERMINAL-3.5MM-2_LOCK
L1, L3, L5, L6, L8: FB; 1206
L2: 5.4uH; PIS2816
L4: 10uH; 0603
L7: FERRITE; C1206K
LB: Light Board; MA03-2
LED1: 12V; CHIPLED_0603
LED2, LED3, LED4, LED5, LED6, LED7, LED8, LED9, LED10, LED11, LED12, LED13, LED14, LED15, LED16, LED17, LED18, LED19, LED20, LED21, LED22, LED23, LED30: LED-0603
LED27: HEARTBEAT; LED-0603
LED28: 3.3V; LED-0603
LED29: Power; CHIPLED_0603
MUX: MA03-2
OK1: PC817; SMD4-7
PICICSP: PIC-ICSP; 1X06-SIP_LOCK
Q1, Q2, Q3, Q4, Q5, Q6, Q7, Q8, Q9, Q10, Q11, Q12, Q13, Q14, Q15, Q16, Q17, Q18, Q19, Q20: IMD10A; SC-74
Q21: SOT23
R1: 1K; R0603
R2, R55, R56, R57, R58, R59, R60, R61, R62, R63, R64, R65, R66, R67, R68, R69, R70, R71, R72, R73, R74: 4.7k; 0603-RES
R3: 3.3k; 0603-RES
R4, R23, R30, R39, R40, R41, R42: 10k; 0603-RES
R5, R6, R51: 330; 0603-RES
R7, R15, R16, R17, R18: RESPACK_4X0603
R8, R9, R10, R11: 330; RESPACK_4X0603
R12: 10k; R0603
R13: 30k; R0603
R14: .10; R2512
R20: 100k; 0603-RES
R21, R22, R24: 10K; 0603-RES
R26: 1k; R0603
R27, R28: 10K; R0603
R29, R43, R45, R52, R54: 180; R0603
R32: 2.26K; R0603
R33, R34, R36, R37: 49.9; R0603
R35: 4.7k; R0603
R38, R44: 2k; 0603-RES
R46, R47, R50: 100; 0603-RES
R48, R49: 3.3k; RESPACK_4X0603
R53: 330; R0603
S1, S2: TACTILE_SWITCH_SMD
SJ1, SJ2: SJ_3_PASTE1&2
SKEW: FIDUCIAL; FIDUCIAL_1MM
U$6: PTC2018; 2018
X1: USBPTH-VERTICAL; USB-B-PTH-VERTICAL
X2: HEADER_POS4_70545; 70545-POS4
X3: HEADER_POS5_70545; 70545-POS5
X4: SI-50014
XTAL1: 16mhz; CRYSTAL-SMD-5X3
XTAL2: 25Mhz; CRYSTAL-SMD-5X3

Connections:
5V: C2.1, C7.2, C10.+, C11.A, C12.1, C13.1, C14.2, C15.1, C17.1, C18.2, C23.1, C34.1, C54.2, C55.1, C56.1, IC2.4, IC2.20, IC3.16, IC4.16, IC6.VDD, IC8.5, IC8.17, IC8.38, IC9.1, IC12.8, IC13.1, ICSP.2, JP4.3, L3.2, L6.1, LB.1, MUX.2, OK1.4, R5.2, R6.2, R21.2, R22.2, R24.2, R30.2, R38.2, R44.2, R46.1, R53.2, SJ1.1, SJ2.1
5VA: C40.1, C57.1, JP5.1, L4.1, L6.2
12V: C5.+, C6.1, D1.C, IC1.6, L1.2, Q1.6, Q2.6, Q3.6, Q4.6, Q5.6, Q6.6, Q7.6, Q8.6, Q9.6, Q10.6, Q11.6, Q12.6, Q13.6, Q14.6, Q15.6, Q16.6, Q17.6, Q18.6, Q19.6, Q20.6, R1.2, R14.1, R23.1, U$6.P$1, X2.P$1
12VF: C1.2, L1.1, X3.P$4
!MCLR: IC11.7, PICICSP.1, R35.1
+3V3: C16.1, C21.1, C22.2, C26.1, C28.1, C30.2, C31.1, C32.1, C35.1, C36.1, C39.+, IC5.6, IC7.3, IC7.7, IC7.8, IC9.2, IC10.7, IC10.8, IC11.18, IC11.19, IC11.26, IC11.38, IC11.48, IC11.49, IC11.54, IC11.57, L7.1, PICICSP.2, R27.2, R28.2, R35.2, R52.1
A: IC12.6, JP6.1, R47.1, R50.1
AGND: C25.2, C27.2, C40.2, C41.2, C42.2, C43.2, C44.2, C57.2, JP5.6, L5.2
B: IC12.7, JP3.2, JP6.2, R46.2
BT_STATUS: IC8.40, LB.2, R26.2, R51.1
CLR_CONFIG: IC11.17, R29.2
CS_DF: IC7.1, IC11.3
CS_EEPROM: IC5.5, IC11.2, R28.1
CS_SRAM: IC10.1, IC11.1
CTSRTS: IC8.26, IC12.2, IC12.3
ESTOP: IC8.25, OK1.3, R20.1
ESTOP-EXT: R3.1, X2.P$2
ETH_MISO: IC5.4, IC7.2, IC10.2, IC11.63
ETH_MOSI: IC5.3, IC7.5, IC10.5, IC11.61
ETH_SCK: IC5.1, IC7.6, IC10.6, IC11.62
ETH_STATUS: IC11.64, LB.4, R54.1
GND: $$U$1.1, $$U$1.12, $$U$1.23, C1.1, C2.2, C3.2, C5.-, C6.2, C7.1, C8.2, C9.-, C10.-, C11.C, C12.2, C13.2, C14.1, C15.2, C16.2, C17.2, C18.1, C19.1, C20.1, C21.2, C22.1, C23.2, C24.2, C26.2, C28.2, C29.2, C30.1, C31.2, C32.2, C33.2, C34.2, C35.2, C36.2, C37.1, C38.2, C39.-, C45.2, C54.1, C55.2, C56.2, D1.A, D2.A, D11.3, IC1.4, IC2.7, IC2.18, IC2.21, IC2.25, IC2.26, IC3.8, IC4.8, IC5.2, IC6.GND, IC7.4, IC8.6, IC8.18, IC8.28, IC8.39, IC9.3, IC10.4, IC11.9, IC11.20, IC11.25, IC11.41, IC11.45, IC11.52, IC11.55, IC11.56, IC12.5, IC13.3, ICSP.6, JP2.1, JP4.1, L5.1, L8.2, LB.6, LED1.C, LED4.C, LED5.C, LED6.C, LED7.C, LED8.C, LED9.C, LED10.C, LED11.C, LED12.C, LED13.C, LED14.C, LED15.C, LED16.C, LED17.C, LED18.C, LED19.C, LED20.C, LED21.C, LED22.C, LED23.C, LED27.C, LED28.C, LED29.C, LED30.C, MUX.1, OK1.2, PICICSP.3, Q1.3, Q2.3, Q3.3, Q4.3, Q5.3, Q6.3, Q7.3, Q8.3, Q9.3, Q10.3, Q11.3, Q12.3, Q13.3, Q14.3, Q15.3, Q16.3, Q17.3, Q18.3, Q19.3, Q20.3, Q21.2, R4.1, R12.1, R15.5, R15.6, R15.7, R15.8, R16.5, R16.6, R16.7, R16.8, R17.1, R17.2, R17.3, R17.4, R18.1, R18.2, R18.3, R18.4, R20.2, R32.1, R43.1, R45.1, R47.2, S1.3, S1.4, S2.3, S2.4, SJ1.3, SJ2.3, X1.GND, X2.P$4, X3.P$5, X4.4, X4.S1
GNDIN: C46.2, C47.2, C48.2, C49.2, C50.2, C51.2, C52.2, C53.2, D3.2, D4.2, D5.2, D6.2, D7.2, D8.2, D9.2, D10.2, INPUTS.1, L8.1
IN1: C46.1, D3.1, IC8.37, R48.8
IN2: C47.1, D4.1, IC8.36, R48.7
IN3: C48.1, D5.1, IC8.35, R48.6
IN4: C49.1, D6.1, IC8.34, R48.5
IN5: C50.1, D7.1, IC8.21, R49.8
IN6: C51.1, D8.1, IC8.22, R49.7
IN7: C52.1, D9.1, IC8.23, R49.6
IN8: C53.1, D10.1, IC8.24, R49.5
LEDA: IC11.24, X4.A1
LEDB: IC11.23, X4.A2
MISO: IC8.2, ICSP.1
MOSI: IC8.1, ICSP.4
MR: IC3.10, R22.1
unnamed: Q20.4, R55.1
unnamed: Q20.5, R55.2
unnamed: Q1.4, R74.1
unnamed: LED2.A, R5.1
unnamed: IC11.50, R33.2, X4.2
unnamed: C29.1, IC8.8, XTAL1.3
unnamed: LED28.A, R52.2
unnamed: IC11.47, R37.2, X4.7
unnamed: LED27.A, R51.2
unnamed: Q21.3, R23.2, X2.P$3
unnamed: C24.1, IC8.7, XTAL1.1
unnamed: Q1.5, R74.2
unnamed: Q21.1, R26.1
unnamed: Q2.5, R73.2
unnamed: D2.C, IC1.2, L2.2
unnamed: Q2.4, R73.1
unnamed: IC1.1, IC1.7, IC1.8, R14.2
unnamed: IC1.5, R12.2, R13.2
unnamed: C25.1, IC8.29
unnamed: C8.1, IC1.3
unnamed: C27.1, IC8.27, L4.2
unnamed: Q3.4, R72.1
unnamed: Q3.5, R72.2
unnamed: Q4.5, R71.2
unnamed: Q4.4, R71.1
unnamed: IC11.46, R36.2, X4.8
unnamed: IC11.53, R32.2
unnamed: IC11.51, R34.2, X4.1
unnamed: C33.1, L7.2, R33.1, R34.1, X4.3
unnamed: C41.1, IC8.30, R39.1
unnamed: C42.1, IC8.31, R40.1
unnamed: C43.1, IC8.32, R41.1
unnamed: C44.1, IC8.33, R42.1
unnamed: JP5.2, R39.2
unnamed: JP5.3, R40.2
unnamed: JP5.4, R41.2
unnamed: JP5.5, R42.2
unnamed: Q5.5, R70.2
unnamed: IC4.10, R24.1
unnamed: LED3.A, R6.1
unnamed: Q5.4, R70.1
unnamed: Q6.5, R69.2
unnamed: LED1.A, R1.1
unnamed: LED10.A, R10.8
unnamed: IC2.19, R2.1, R4.2
unnamed: OK1.1, R3.2
unnamed: C3.1, IC2.17
unnamed: C38.1, R36.1, R37.1
unnamed: R45.2, X4.C1
unnamed: R43.2, X4.C2
unnamed: C19.2, C20.2, IC11.10
unnamed: Q6.4, R69.1
unnamed: C37.2, IC11.40, XTAL2.1
unnamed: C45.1, IC11.39, XTAL2.3
unnamed: LED30.A, R54.2
unnamed: LED11.A, R10.7
unnamed: LED12.A, R10.6
unnamed: LED13.A, R10.5
unnamed: LED6.A, R9.8
unnamed: LED7.A, R9.7
unnamed: LED8.A, R9.6
unnamed: LED9.A, R9.5
unnamed: LED22.A, R8.8
unnamed: LED23.A, R8.7
unnamed: LED4.A, R8.6
unnamed: LED5.A, R8.5
unnamed: LED18.A, R7.8
unnamed: IC2.16, X1.D-
unnamed: LED19.A, R7.7
unnamed: LED29.A, R53.1
unnamed: JP2.2, U$6.P$2
unnamed: C9.+, L2.1, L3.1, R13.1
unnamed: LED20.A, R7.6
unnamed: C4.1, JP1.1
unnamed: LED21.A, R7.5
unnamed: INPUTS.2, R48.1
unnamed: INPUTS.3, R48.2
unnamed: INPUTS.4, R48.3
unnamed: INPUTS.5, R48.4
unnamed: INPUTS.6, R49.1
unnamed: INPUTS.7, R49.2
unnamed: INPUTS.8, R49.3
unnamed: INPUTS.9, R49.4
unnamed: Q7.5, R68.2
unnamed: IC2.15, X1.D+
unnamed: Q7.4, R68.1
unnamed: IC3.14, IC4.9
unnamed: Q8.5, R67.2
unnamed: JP3.1, R50.2
unnamed: Q8.4, R67.1
unnamed: Q9.5, R66.2
unnamed: LED14.A, R11.8
unnamed: LED15.A, R11.7
unnamed: LED16.A, R11.6
unnamed: LED17.A, R11.5
unnamed: Q9.4, R66.1
unnamed: Q10.5, R65.2
unnamed: IC13.7, SJ1.2
unnamed: IC13.8, SJ2.2
unnamed: Q10.4, R65.1
unnamed: Q11.5, R64.2
unnamed: Q11.4, R64.1
unnamed: Q12.5, R63.2
unnamed: Q12.4, R63.1
unnamed: Q13.5, R62.2
unnamed: Q13.4, R62.1
unnamed: Q14.5, R61.2
unnamed: Q14.4, R61.1
unnamed: Q15.5, R60.2
unnamed: Q15.4, R60.1
unnamed: Q16.5, R59.2
unnamed: Q16.4, R59.1
unnamed: Q17.5, R58.2
unnamed: Q17.4, R58.1
unnamed: Q18.5, R57.2
unnamed: Q18.4, R57.1
unnamed: Q19.5, R56.2
unnamed: Q19.4, R56.1
OE: IC3.13, IC4.13, IC8.42, MUX.3, R21.1
ONEWIREDATA: IC13.2, JP4.2
OUT1: IC8.13, Q20.2, R11.4
OUT2: IC8.14, Q19.2, R11.3
OUT3: IC8.15, Q18.2, R11.2
OUT4: IC8.16, Q17.2, R11.1
OUT5: IC4.15, Q16.2, R10.4, R18.5
OUT6: IC4.1, Q15.2, R10.3, R18.6
OUT7: IC4.2, Q14.2, R10.2, R18.7
OUT8: IC4.3, Q13.2, R10.1, R18.8
OUT9: IC4.4, Q12.2, R9.4, R17.5
OUT10: IC4.5, Q11.2, R9.3, R17.6
OUT11: IC4.6, Q10.2, R9.2, R17.7
OUT12: IC4.7, Q9.2, R9.1, R17.8
OUT13: IC3.15, Q8.2, R8.4, R16.1
OUT14: IC3.1, Q7.2, R8.3, R16.2
OUT15: IC3.2, Q6.2, R8.2, R16.3
OUT16: IC3.3, Q5.2, R8.1, R16.4
OUT17: IC3.4, Q4.2, R7.4, R15.1
OUT18: IC3.5, Q3.2, R7.3, R15.2
OUT19: IC3.6, Q2.2, R7.2, R15.3
OUT20: IC3.7, Q1.2, R7.1, R15.4
PGC: IC11.42, PICICSP.5
PGD: IC11.37, PICICSP.4
RESET: IC2.2, JP1.2
RESET_BT: C4.2, IC8.4, ICSP.5, R30.1, S1.1, S1.2
RESET_ETH: R27.1, R29.1, S2.1, S2.2
RXD: IC2.1, IC8.9
RXD1: IC8.11, IC12.1
SCK: IC8.3, ICSP.3
SCL: D11.2, IC6.SCLK, IC8.19, IC11.34, IC13.4, LB.5, R44.1, X3.P$2
SDA: D11.1, IC6.SDA, IC8.20, IC11.35, IC13.5, LB.3, R38.1, X3.P$1
SER: IC4.14, IC8.41
SER2: IC3.9, MUX.6
SH_CP: IC3.11, IC4.11, IC8.44, MUX.5
ST_CP: IC3.12, IC4.12, IC8.43, MUX.4
SWITCHED1: $$U$1.2, Q20.1
SWITCHED2: $$U$1.3, Q19.1
SWITCHED3: $$U$1.4, Q18.1
SWITCHED4: $$U$1.5, Q17.1
SWITCHED5: $$U$1.6, Q16.1
SWITCHED6: $$U$1.7, Q15.1
SWITCHED7: $$U$1.8, Q14.1
SWITCHED8: $$U$1.9, Q13.1
SWITCHED9: $$U$1.10, Q12.1
SWITCHED10: $$U$1.11, Q11.1
SWITCHED11: $$U$1.13, Q10.1
SWITCHED12: $$U$1.14, Q9.1
SWITCHED13: $$U$1.15, Q8.1
SWITCHED14: $$U$1.16, Q7.1
SWITCHED15: $$U$1.17, Q6.1
SWITCHED16: $$U$1.18, Q5.1
SWITCHED17: $$U$1.19, Q4.1
SWITCHED18: $$U$1.20, Q3.1
SWITCHED19: $$U$1.21, Q2.1
SWITCHED20: $$U$1.22, Q1.1
TXD: IC2.5, IC8.10
TXD1: IC8.12, IC12.4
USB_RX_LED: IC2.22, LED3.C
USB_TX_LED: IC2.23, LED2.C
VBUS: R2.2, X1.VBUS
