BrewTroller/BoardFiles/(notices)

Notices in the files:
Phoenix 2.0/BrewTrollerPhoenix.brd:
Copyright 2015
